YaoKunS/ESP32-Drone/(notices)

Notices in the files:
README.md:
License: GPLv3
